photovoltaic-art/SUNDIAL/hardware/carrier/bom.csv

References | Qty | Value / rating | Footprint | Fitted | Manufacturer | MPN | Confirm | Placement | Section (first) | Notes
BT1 | 1 | CR2032 holder (no charging) | Battery:BatteryHolder_Keystone_3034_1x20mm | yes | Keystone Electronics | 3034 |  | BT1: near - U1 pin 14 (VBAT) | 5
C3 | 1 | 470u 10 V low ESR | Capacitor_SMD:CP_Elec_8x10.5 | yes | Panasonic | EEE-FK1A471P | 470 uF 10 V FK series, 8 x 10.2 mm; check fit on the 8 x 10.5 footprint | C3: critical - J14 pin 15 (ESP32 VIN) to J14 pin 14 (GND) | 3 | Close to ESP32 VIN
C4 C5 C6 C9 C10 | 5 | 100n | Capacitor_SMD:C_0603_1608Metric | yes | Murata | GRM188R71H104KA93D |  | C4: critical - J14 pin 15 (VIN), next to C3; C5: critical - J14 pin 4 (GPIO 34) to GND, with R2; C6: critical - U2 pin 5 (VS) to U2 pin 2 (GND); C9: critical - J8 pin 4 (VDD), next to C8; C10: critical - U1 pin 2 (VCC) to GND | 1 | U1 decoupling; U2 decoupling
C7 | 1 | 10n | Capacitor_SMD:C_0603_1608Metric | yes | Murata | GRM188R71H103KA01D |  | C7: critical - J14 pin 5 (GPIO 35) to GND, with R6 | 1
C8 | 1 | 10u | Capacitor_SMD:C_0805_2012Metric | yes | Murata | GRM21BR61C106KE15L |  | C8: critical - J8 pin 4 (VDD) to GND | 7
C11 C12 C13 | 3 | 1u | Capacitor_SMD:C_0603_1608Metric | yes | Murata | GRM188R71E105KA12D |  | C11: critical - U3 pin 2 (VDD) to U3 pin 4 (GND); C12: critical - U4 pin 5 (IN) to GND; C13: critical - U4 pin 1 (OUT) to GND | 1 | ADDED, not in spec v1: U3 supply decoupling (datasheet requirement); ADDED, not in spec v1: U4 input capacitor; ADDED, not in spec v1: U4 output capacitor
D0 | 1 | >=100 V >=15 A dual Schottky (e.g. 20 A 100 V) | Package_TO_SOT_SMD:TO-263-2 | yes | onsemi | MBRB20100CTT4G | D2PAK, 100 V 20 A dual common cathode, anodes (pins 1, 3) in parallel | D0: critical - Right after J1, in the sun loop J1 -> D0 -> Q1 -> RSH1 | 1 | Input protection; cooling area; carries AUX current too
D1 | 1 | S3M (1000 V 3 A) | Diode_SMD:D_SMC | yes | Vishay | S3M-E3/57T |  | D1: near - Between F1 and J2 (buck input) | 2 | Reverse polarity; blocks Q1 pulses
D2 | 1 | SMAJ5.0A (TVS, unidirectional) | Diode_SMD:D_SMA | yes | Littelfuse | SMAJ5.0A |  | D2: near - J3 (buck output terminal) | 3
D3 | 1 | ESD 3.3 V (e.g. PESD3V3L1BA) | Diode_SMD:D_SOD-323 | yes | Nexperia | PESD3V3L1BA,115 |  | D3: critical - J4 pin 2 (DQ_T), short path to GND | 6 | At the terminal
D4 | 1 | SS14 (flyback clamp) | Diode_SMD:D_SMA | yes | Vishay | SS14-E3/61T |  | D4: near - J11 pin 2 (5V SW) | 9
D5 | 1 | Schottky >=100 V >=10 A (MBR10100 class) | Package_TO_SOT_THT:TO-220-2_Vertical | yes | onsemi | MBR10100G |  | D5: near - Next to J12, with copper for cooling | 10 | Essential: isolates add-on capacitors from Q1 pulses; heatsink if AUX > ~2 A
D6 | 1 | DNP: SMCJ58A TVS (fit after bench test if needed) | Diode_SMD:D_SMC | no (DNP) | Littelfuse | SMCJ58A | DNP | D6: near - Q1 drain (PV+), short path to the star ground | 1 | ADDED, review 2: footprint only. If fitted, Q1 must be >= 100 V (clamp ~90 V)
F1 | 1 | 2 A slow-blow | Fuse:Fuse_1812_4532Metric | yes | (manufacturer to propose) |  | 1812 time-delay (slow-blow) fuse, 2 A, >= 63 V DC. If no 1812 part suits, Bourns SF-1206S200-2 (1206, 2 A time-lag) with the footprint changed to 1206 | F1: near - Off the Q1 drain node (PV+), start of the board-supply branch | 2 | After the Q1 node
F2 | 1 | PTC 0.5 A hold | Fuse:Fuse_1206_3216Metric | yes | Bourns | MF-NSMF050-2 |  | F2: free - Between the +5V rail and J11 pin 1 | 9
F3 | 1 | PTC 0.2 A hold | Fuse:Fuse_0805_2012Metric | yes | Bourns | MF-PSMF020X-2 | 0805, 0.2 A hold; confirm size | F3: free - Between +3V3 and the header/J11 3V3 pins | 9 | Feeds J11 3V3 and the header 3V3 pins
F4 | 1 | ATO blade holder, fuse NOT fitted (<=3 A on v1; 9 A only with D5 heatsink) | Fuse:FuseHolder_Blade_ATO_Littelfuse_FLR_178.6165 | holder only | Littelfuse | 178.6165.0002 | Holder only, fuse not fitted | F4: near - High-current path D0 -> F4 -> D5 -> J12 | 10 | Empty holder = AUX dead
H1 H2 H3 H4 | 4 | M3 | MountingHole:MountingHole_3.2mm_M3 | yes |  |  | mounting holes, no part |  | Mechanical | 3.5 mm from corners, provisional
J1 | 1 | PANEL+ / PANEL- (>=15 A, 4-6 mm2) | TerminalBlock_MetzConnect:TerminalBlock_MetzConnect_Type067_RT01902HDWC_1x02_P10.00mm_Horizontal | yes | Metz Connect | RT01902HDWC |  |  | 1 | Board edge; GND here is PANEL-
J2 | 1 | BUCK IN + / - | TerminalBlock_Phoenix:TerminalBlock_Phoenix_MKDS-1,5-2-5.08_1x02_P5.08mm_Horizontal | yes | Phoenix Contact | 1715721 | MKDS 1,5/ 2-5,08 |  | 2 | To ANGEEK buck input
J3 | 1 | BUCK OUT + / - (set 5.0 V) | TerminalBlock_Phoenix:TerminalBlock_Phoenix_MKDS-1,5-2-5.08_1x02_P5.08mm_Horizontal | yes | Phoenix Contact | 1715721 | MKDS 1,5/ 2-5,08 |  | 3
J4 | 1 | DS18B20: 3V3 / DATA / GND | TerminalBlock_Phoenix:TerminalBlock_Phoenix_PT-1,5-3-3.5-H_1x03_P3.50mm_Horizontal | yes | Phoenix Contact | 1984633 | PT 1,5/ 3-3,5-H |  | 6 | red / yellow / black
J5 | 1 | Optional 2nd probe | TerminalBlock_Phoenix:TerminalBlock_Phoenix_PT-1,5-3-3.5-H_1x03_P3.50mm_Horizontal | yes | Phoenix Contact | 1984633 | PT 1,5/ 3-3,5-H |  | 6 | In parallel with J4
J6 | 1 | Supercap 2.7 V 10 F (upper) | TerminalBlock_Phoenix:TerminalBlock_Phoenix_MKDS-1,5-2-5.08_1x02_P5.08mm_Horizontal | yes | Phoenix Contact | 1715721 | MKDS 1,5/ 2-5,08 |  | 3 | Silkscreen - side (stripe)
J7 | 1 | Supercap 2.7 V 10 F (lower) | TerminalBlock_Phoenix:TerminalBlock_Phoenix_MKDS-1,5-2-5.08_1x02_P5.08mm_Horizontal | yes | Phoenix Contact | 1715721 | MKDS 1,5/ 2-5,08 |  | 3 | Silkscreen - side (stripe)
J8 | 1 | microSD push-push with detect (Hirose DM3AT) | Connector_Card:microSD_HC_Hirose_DM3AT-SF-PEJM5 | yes | Hirose | DM3AT-SF-PEJM5 |  |  | 7 | At a board edge; DAT1, DAT2 not used in SPI mode
J9 | 1 | Spare: 3V3 GND 32 33 36 26 27 13 14 | Connector_PinHeader_2.54mm:PinHeader_1x09_P2.54mm_Vertical | yes | Würth Elektronik | 61300911121 |  |  | 8 | Silkscreen: 32/33/36 analog, 36 input only
J10 | 1 | UART: 3V3 GND RX2(16) TX2(17) | Connector_PinHeader_2.54mm:PinHeader_1x04_P2.54mm_Vertical | yes | Würth Elektronik | 61300411121 |  |  | 8
J11 | 1 | 5V / 5V SW / 3V3 / GND | TerminalBlock_Phoenix:TerminalBlock_Phoenix_PT-1,5-4-3.5-H_1x04_P3.50mm_Horizontal | yes | Phoenix Contact | 1984646 | PT 1,5/ 4-3,5-H |  | 9
J12 | 1 | AUX + / - (>=15 A) | TerminalBlock_MetzConnect:TerminalBlock_MetzConnect_Type067_RT01902HDWC_1x02_P10.00mm_Horizontal | yes | Metz Connect | RT01902HDWC |  |  | 10 | AUX- is PANEL-: never through the shunt
J13 | 1 | I2C: 3V3 GND SDA SCL | Connector_PinHeader_2.54mm:PinHeader_1x04_P2.54mm_Vertical | yes | Würth Elektronik | 61300411121 |  |  | 8
J14 | 1 | ESP32 left row: EN,36,39,34,35,32,33,25,26,27,14,12,13,GND,VIN | Connector_PinSocket_2.54mm:PinSocket_1x15_P2.54mm_Vertical | yes | Würth Elektronik | 61301511821 | Female socket, 15 way; confirm it is the socket, not the pin header |  | 4 | Row spacing 25.4 mm, provisional
J15 | 1 | ESP32 right row: 23,22,1,3,21,19,18,5,17,16,4,2,15,GND,3V3 | Connector_PinSocket_2.54mm:PinSocket_1x15_P2.54mm_Vertical | yes | Würth Elektronik | 61301511821 | Female socket, 15 way; confirm it is the socket, not the pin header |  | 4 | EN, 1, 3, 2, 12, 15 not brought out
JP1 | 1 | Jumper: remove = sun sensor off | Connector_PinHeader_2.54mm:PinHeader_1x02_P2.54mm_Vertical | yes | Würth Elektronik | 61300211121 | Plus a 2.54 mm jumper (fitted by the builder) |  | 1
LED1 | 1 | Green, ~0.3 mA | LED_SMD:LED_0603_1608Metric | yes | Würth Elektronik | 150060GS75000 |  | LED1: free - Visible when the box is open | 3 | 5 V present; dim on purpose
Q1 | 1 | N-MOSFET >=60 V (>=100 V if D6 fitted) >=20 A Rds(on)<=20 mOhm @4.5 V | Package_TO_SOT_SMD:TO-252-2 | yes | Infineon | IRLR3110ZTRPBF | 100 V logic-level D-Pak; confirm Rds(on) <= 20 mOhm at Vgs 4.5 V from the datasheet |  | 1 | Sun sensor: shorts the panel ~1 ms every 10 s
R1 | 1 | 100k 1% | Resistor_SMD:R_0805_2012Metric | yes | Yageo | RC0805FR-07100KL |  | R1: near - Next to R2; its top end on PV_F after F1 | 2
R2 | 1 | 4k7 1% | Resistor_SMD:R_0603_1608Metric | yes | Yageo | RC0603FR-074K7L |  | R2: near - J14 pin 4 (ESP32 GPIO 34), with C5 | 2 | Was 5k6; changed after review (48 V -> 2.15 V)
R4 | 1 | 10R | Resistor_SMD:R_0603_1608Metric | yes | Yageo | RC0603FR-0710RL |  | R4: critical - Q1 gate pad, between U3 pin 5 (OUT) and Q1 gate | 1
R5 R9 R14 R15 R16 R17 | 6 | 10k | Resistor_SMD:R_0603_1608Metric | yes | Yageo | RC0603FR-0710KL |  | R5: near - U3 pin 3 (IN); R9: free - Next to LED1; R14: near - J8 pin 2 (CS); R15: near - J8 pin 3 (MOSI); R16: near - J8 pin 7 (MISO); R17: near - J8 pin 10 (detect) | 1 | Also keeps GPIO 5 high at boot; Q1 stays off while the ESP32 boots
R6 | 1 | 1k | Resistor_SMD:R_0603_1608Metric | yes | Yageo | RC0603FR-071KL |  | R6: near - J14 pin 5 (ESP32 GPIO 35), together with C7 | 1
R7 R8 | 2 | 10k | Resistor_SMD:R_0805_2012Metric | yes | Yageo | RC0805FR-0710KL |  | R7: near - J6 (upper supercap terminal), across +5V and MID; R8: near - J7 (lower supercap terminal), across MID and GND | 3 | Balancing
R10 R11 R12 | 3 | 4k7 | Resistor_SMD:R_0603_1608Metric | yes | Yageo | RC0603FR-074K7L |  | R10: free - On SDA, near U1 or J13; R11: free - On SCL, near U1 or J13; R12: near - J4/J5 | 5
R13 | 1 | 100R | Resistor_SMD:R_0603_1608Metric | yes | Yageo | RC0603FR-07100RL |  | R13: near - Between J4/D3 and the ESP32 side of DQ | 6
R18 R21 | 2 | 100k | Resistor_SMD:R_0603_1608Metric | yes | Yageo | RC0603FR-07100KL |  | R18: near - U4 pin 4 (EN); R21: critical - Directly across Q1 gate and source pads | 1 | ADDED, review 2: Q1 gate-source pull-down; holds Q1 off while U3 is unpowered at dawn; Switched output off at boot
R19 | 1 | 0R | Resistor_SMD:R_0603_1608Metric | yes | Yageo | RC0603JR-070RL |  | R19: near - U4 pin 4 (EN), on the trace from GPIO 27 | 9 | Remove to free GPIO 27
R20 | 1 | DNP | Resistor_SMD:R_0603_1608Metric | no (DNP) | Yageo | RC0603FR-071KL | DNP; value to set on the bench if a long probe cable needs it | R20: near - J4/J5, beside R12 | 6 | Spec ref R12b. Footprint only: stronger pull-up for long cable
RSH1 | 1 | 5m 1% 2512 >=2 W | Resistor_SMD:R_2512_6332Metric | yes | Bourns | CRA2512-FZ-R005ELF | 5 mOhm 1 % 3 W |  | 1 | Spec ref R_SH. Kelvin connections to U2; star ground at the GND end
RSH2 | 1 | DNP (option: 2x 10m) | Resistor_SMD:R_2512_6332Metric | no (DNP) | Bourns | CRA2512-FZ-R010ELF | DNP; option: two in parallel instead of RSH1 |  | 1 | Spec ref R_SH2. Footprint only
TP1 | 1 | PV+ | TestPoint:TestPoint_Loop_D2.50mm_Drill1.0mm | yes | Keystone Electronics | 5000 |  |  | 8
TP2 | 1 | BUCK_IN+ | TestPoint:TestPoint_Loop_D2.50mm_Drill1.0mm | yes | Keystone Electronics | 5000 |  |  | 8
TP3 | 1 | +5V | TestPoint:TestPoint_Loop_D2.50mm_Drill1.0mm | yes | Keystone Electronics | 5000 |  |  | 8
TP4 | 1 | MID | TestPoint:TestPoint_Loop_D2.50mm_Drill1.0mm | yes | Keystone Electronics | 5000 |  |  | 8
TP5 | 1 | +3V3 | TestPoint:TestPoint_Loop_D2.50mm_Drill1.0mm | yes | Keystone Electronics | 5000 |  |  | 8
TP6 | 1 | GND | TestPoint:TestPoint_Loop_D2.50mm_Drill1.0mm | yes | Keystone Electronics | 5000 |  |  | 8
TP7 | 1 | VDIV | TestPoint:TestPoint_Loop_D2.50mm_Drill1.0mm | yes | Keystone Electronics | 5000 |  |  | 8
TP8 | 1 | ISENSE | TestPoint:TestPoint_Loop_D2.50mm_Drill1.0mm | yes | Keystone Electronics | 5000 |  |  | 8
TP9 | 1 | GATE | TestPoint:TestPoint_Loop_D2.50mm_Drill1.0mm | yes | Keystone Electronics | 5000 |  |  | 8
TP10 | 1 | RTC_INT | TestPoint:TestPoint_Loop_D2.50mm_Drill1.0mm | yes | Keystone Electronics | 5000 |  |  | 8
TP11 | 1 | RTC_32K | TestPoint:TestPoint_Loop_D2.50mm_Drill1.0mm | yes | Keystone Electronics | 5000 |  |  | 8
U1 | 1 | DS3231SN (or RV-3028-C7, firmware change) | Package_SO:SOIC-16W_7.5x10.3mm_P1.27mm | yes | Analog Devices / Maxim | DS3231SN# |  |  | 5 | Symbol DS3231M has the same pinout as DS3231SN (pins 5-12 to GND); RST not connected
U2 | 1 | INA180A3 (gain 100) | Package_TO_SOT_SMD:SOT-23-5 | yes | Texas Instruments | INA180A3IDBVR |  |  | 1 | IN+ and IN- by Kelvin traces from the inner ends of RSH1's pads
U3 | 1 | MCP1416 (or TC4427A class) | Package_TO_SOT_SMD:SOT-23-5 | yes | Microchip | MCP1416T-E/OT |  |  | 1 | Non-inverting, 5 V gate drive
U4 | 1 | Load switch 5 V >=1 A, active-high EN, soft start (AP22804AW5 / TPS22918 class) | Package_TO_SOT_SMD:SOT-23-5 | yes | Diodes Inc. | AP22804AW5-7 |  |  | 9 | Fed from +5V as in the spec; FLG not used
Fitted by the builder (not assembled): |  | ELEGOO ESP32 30-pin; ANGEEK buck 8-60 V set to 5.0 V; 2x 2.7 V 10 F supercaps; CR2032; DS18B20 probe(s); JP1 jumper; AUX fuse; microSD card |  |  |  |  |  |  |  | See CARRIER.md
