photovoltaic-art/SUNDIAL/budget/SUNDIAL-budget.xlsx

Sheet: Summary
SUNDIAL: budget to build the nine panels
Draft, 25 Oct 2026. Hardware, the first event, and yearly running costs (Sole and the event).
Node | Cost (€) | Share
Panels and boards
Sundial hardware
Mounting and plates
The event (2027)
Website, permissions, insurance
Shared and spares
Build subtotal
Contingency
Build total
Each following year: insurance, domain, upkeep, the year's print
Total to build and run the first year
Contingency rate | 15%
Option, not in the total:
Post panel (in place of one wall)
How to use it
Edit only the blue cells: quantities, unit prices and Include (Yes/No) on the Lines sheet, and the contingency rate above (yellow).
Basis on each line: Quote (from the supplier), Listed price (seen online, Oct 2026), Estimate (to be confirmed).
Prices include VAT. The first year's insurance, domain and print are in the build cost; the yearly figure starts from the second year.
To include a post panel, set its lines' Include to Yes on the Lines sheet.
Not included: PVA's labour and travel; the print's sale income.

Sheet: Lines
Node | Item | Qty | Unit (€) | Total (€) | Basis | Source / note | Include
Panels and boards | Retired PV panel, Trina TSM-185DC01 class (9 + 1 spare) | 10 | €30 |  | Estimate | Second-hand / end-of-life; may be donated. Source still to confirm | Yes
Panels and boards | Board designer: schematic review, layout, files (CARRIER.md brief) | 1 | €1000 |  | Estimate | One-off; get quotes (Italian/European design house) | Yes
Panels and boards | Carrier v1, small run of 5, assembled (bench test of the sun sensor) | 5 | €100 |  | Estimate | Small-run setup costs make v1 dear per board | Yes
Panels and boards | Carrier v2, run of 10, assembled (9 panels + 1 spare) | 10 | €60 |  | Estimate | CARRIER.md: order 5 of v1, fix, then 10 of v2 | Yes
Panels and boards | ELEGOO ESP32 30-pin dev boards (v1 bench + v2) | 15 | €9 |  | Estimate |  | Yes
Panels and boards | Buck converter modules (8–60 V in, 5 V out) | 15 | €5 |  | Estimate |  | Yes
Panels and boards | Supercapacitor pairs (2 x 10 F), DS18B20 probe, CR2032 | 10 | €12 |  | Estimate |  | Yes
Panels and boards | IP65 box, glands, breather vent, tamper screws | 10 | €32 |  | Estimate | CARRIER.md: about 150 x 110 x 70 mm | Yes
Panels and boards | Cable, fuses, terminals | 10 | €15 |  | Estimate |  | Yes
Sundial hardware | Gnomon: 15 mm aluminium tube, 45 cm, TIG-welded to its mount | 9 | €40 |  | Estimate | Local fabrication; GNOMON.md | Yes
Sundial hardware | Hour lines and date marks: UV-stable vinyl pinstripe tape, per panel | 9 | €10 |  | Estimate | No numbers, no brackets; GNOMON.md | Yes
Sundial hardware | Stand-offs (aluminium angle) and M6 stainless fixings | 9 | €30 |  | Estimate |  | Yes
Sundial hardware | Hour-line tape test (pilot panel) | 1 | €20 |  | Estimate | README to-do | Yes
Mounting and plates | Wall fixings (anchors, brackets) | 9 | €25 |  | Estimate |  | Yes
Mounting and plates | Wall plate: number and QR code | 9 | €20 |  | Estimate |  | Yes
The event (2027) | Girasole: dwarf sunflowers, pots, soil | 1 | €40 |  | Estimate |  | Yes
The event (2027) | Girasole: chalkboard, stand, ochre and blue chalk | 1 | €90 |  | Estimate |  | Yes
The event (2027) | Flyers | 1 | €100 |  | Estimate |  | Yes
The event (2027) | Screen print set-up: four screens and films | 1 | €400 |  | Estimate | Awaiting the print shop's answer (texts/print-enquiry.md) | Yes
The event (2027) | Screen print run | 50 | €10 |  | Estimate | Edition size and price per print still open; sales may cover it | Yes
Website, permissions, insurance | Domain photovoltaic.art, first year | 1 | €30 |  | Estimate | Check the renewal price (PVA TASKS.md) | Yes
Website, permissions, insurance | Public liability insurance, first year | 1 | €400 |  | Estimate | Get a quote | Yes
Website, permissions, insurance | Permission costs (applications, stamps) | 1 | €100 |  | Estimate | Depends on the route: patto di collaborazione or authorisation | Yes
Shared and spares | Spares: supercaps, coin cells, probe, fixings | 1 | €60 |  | Estimate | SUNDIAL.md 5 | Yes
Shared and spares | Bench supply and test leads | 1 | €60 |  | Estimate | If not already owned | Yes
Shared and spares | Shipping | 1 | €100 |  | Estimate |  | Yes
Post option | Steel post and base | 1 | €450 |  | Estimate | Only where no wall works (POST.md) | No
Post option | Structural engineer's sign-off | 1 | €400 |  | Estimate |  | No
Post option | USB-C PD charger module, sockets, shelf, plate | 1 | €110 |  | Estimate |  | No
Running, each year | Insurance renewal | 1 | €400 |  | Estimate |  | Yes
Running, each year | Domain renewal | 1 | €30 |  | Estimate |  | Yes
Running, each year | Upkeep: coin cells, supercaps over time, cleaning | 1 | €60 |  | Estimate |  | Yes
Running, each year | Screen print set-up for the year's print | 1 | €400 |  | Estimate | Each event makes a new print | Yes
