photovoltaic-art/SUNDIAL/hardware/carrier/outline.dxf

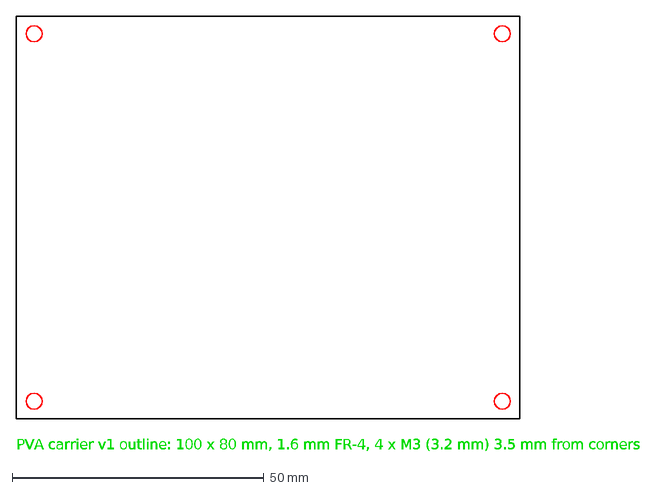
[picture p4: CAD file, 2026-10-27]
hardware/carrier/outline.dxf
PVA carrier v1 outline: 100 x 80 mm, 1.6 mm FR-4, 4 x M3 (3.2 mm) 3.5 mm from corners
