photovoltaic-art/SUNDIAL/hardware/carrier/carrier_schematic.pdf

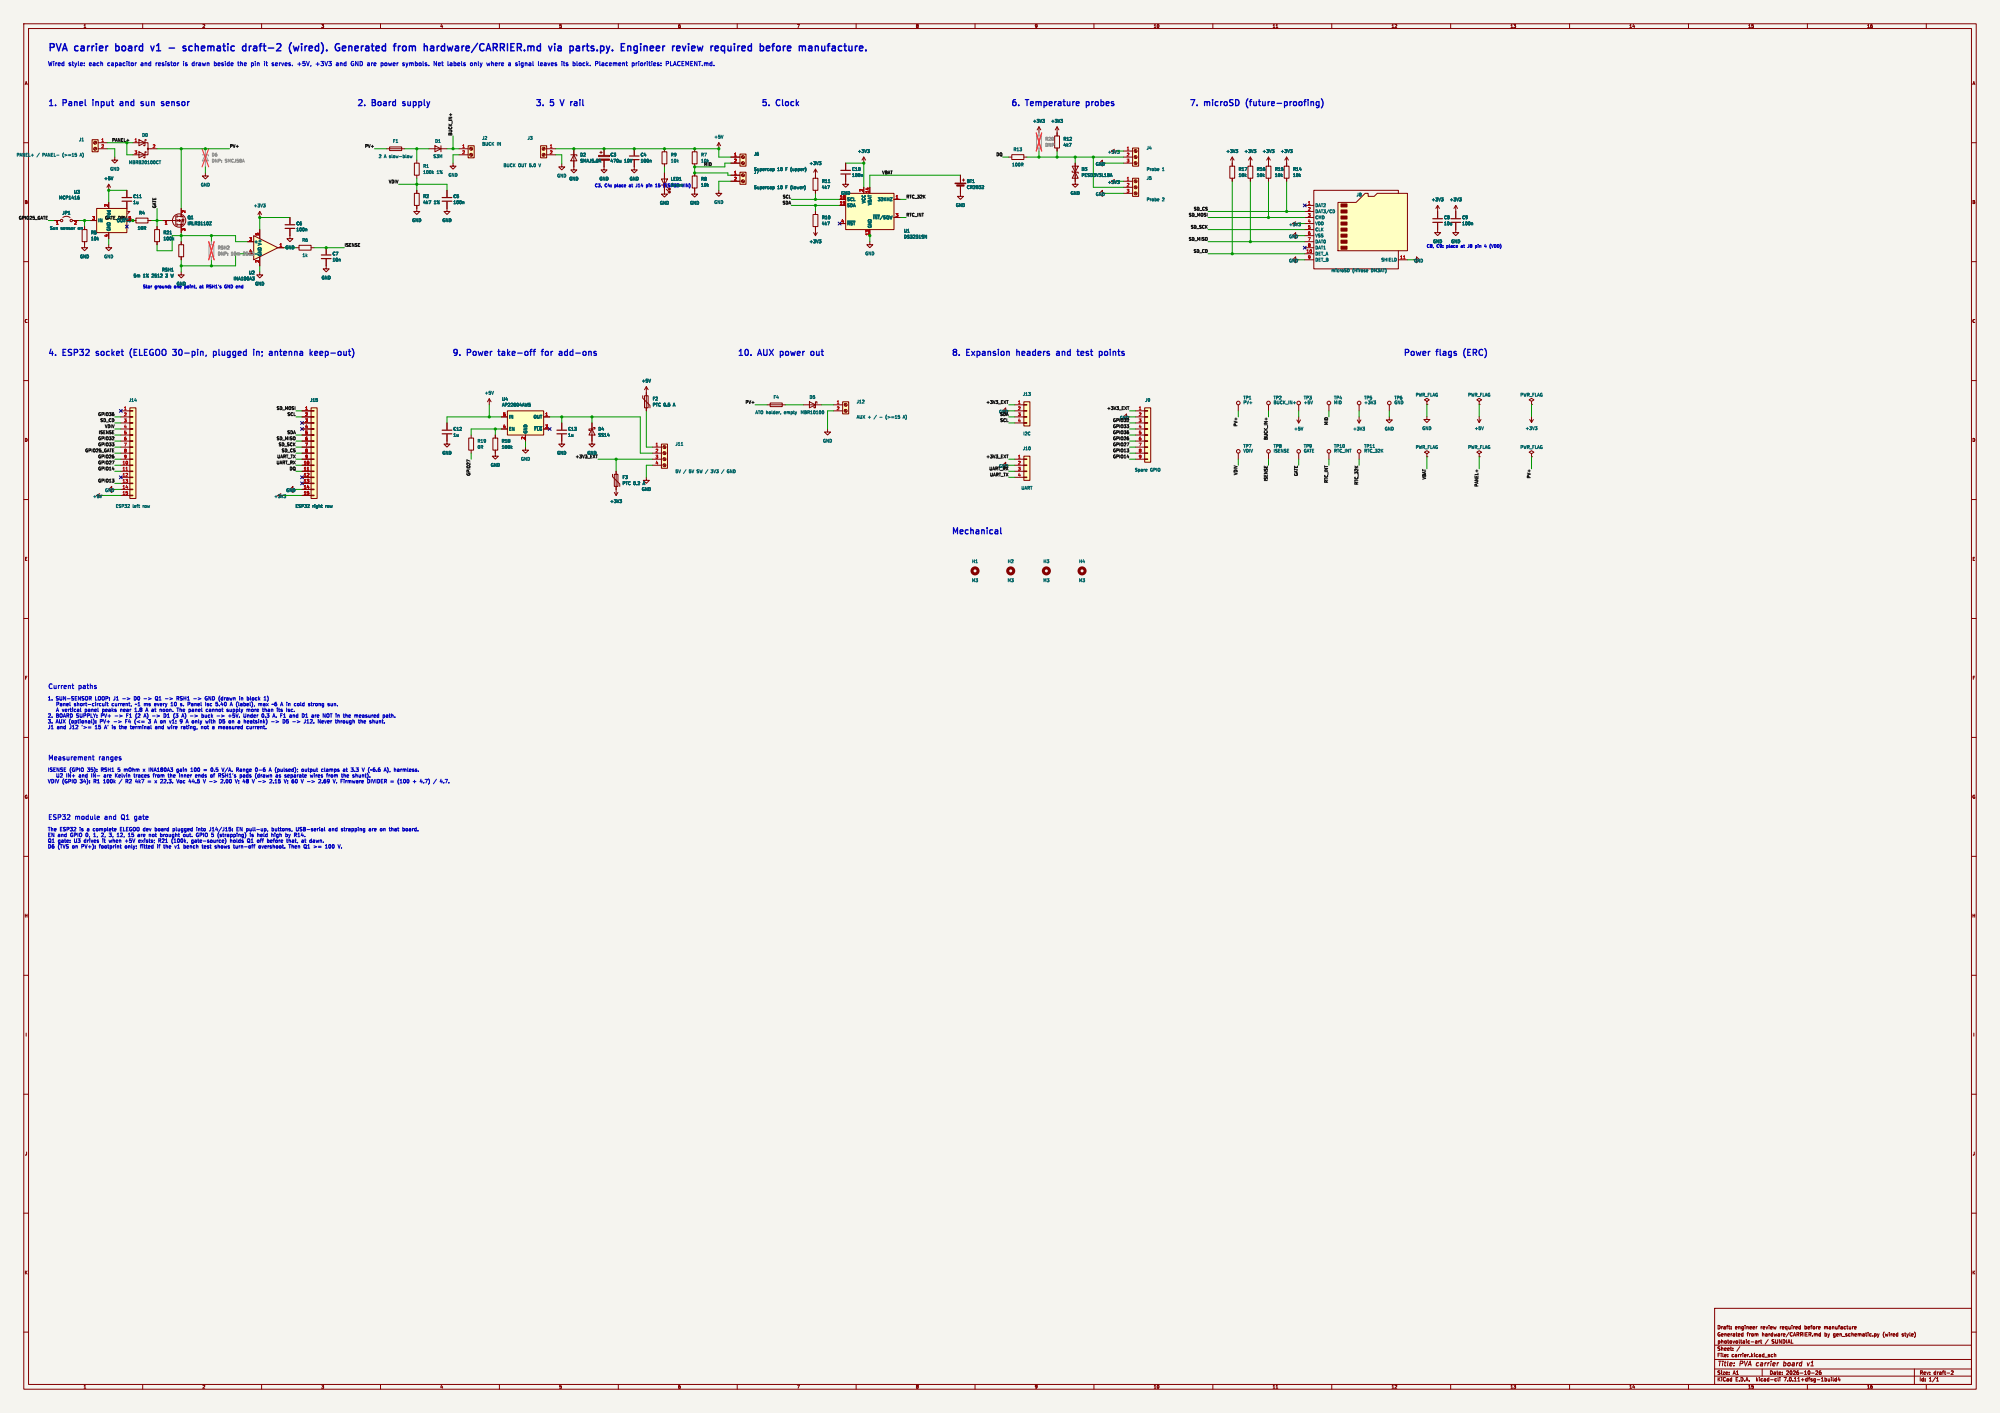
[picture p5: page 1]

8. Expansion headers and test points

Id: 1/1 Title: PVA carrier board v1
