photovoltaic-art/SUNDIAL/(commit log)

2026-10-25 Review fixes and a first budget
    README: the panel is the Trina TSM-185DC01 (was '180 W'). SUNDIAL.md:
    the post variant in layer 1, permissions and upkeep. CARRIER.md: wall or
    post. budget/SUNDIAL-budget.xlsx: about EUR 6,400 to build, EUR 7,300
    with contingency, EUR 890 each following year.
    Claude-Session: https://claude.ai/code/session_01PYggKV6J6nFvCyx7PSvpos
    [SUNDIAL-budget.xlsx]
2026-10-26 Carrier: placement guide for every passive (PLACEMENT.md, BOM Placement column), answering Rush PCB
    Claude-Session: https://claude.ai/code/session_01BMFMt5yCJVT3JQicJnUWqs
    [bom.csv]
2026-10-26 Carrier schematic draft-2: wired style (passives beside and wired to their pins, power symbols, labels only between blocks); netlist unchanged, verified net by net
    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
    [carrier.kicad_sch]
2026-10-26 Carrier schematic: placement note for C3/C4 at ESP32 VIN
    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
    [carrier.kicad_sch]
2026-10-27 Growth model: year 1 SUNDIAL by PVA, year 2 the same nine panels become SUNSET, each node owned separately
    PVA/GROWTH.md: SUNDIAL (no tokens, PVA owns and manages) grows into
    SUNSET at the year-2 spring visit: 4 walls by firmware, 5 interactive
    nodes on the battery tier; anyone can own a node and hold its key; PVA
    writes firmware and rules and manages the website. Sundials stay; Sole
    continues with reference sun sensors. Year-1 sites chosen for year-2
    roles. Linked from SUNDIAL and SUNSET; tokenomics governance adopted.
    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
2026-10-27 As simple as possible: one board everywhere, one firmware image per work, identity written at installation
    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
2026-10-27 Carrier: board outline fixed (100 x 80 mm, M3 holes 3.5 mm from corners) with outline.dxf; mounting on the box's plate
    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
    [outline.dxf]
2026-10-28 Carrier spec: planned for v2, dual-gain sun sensor (U2B INA180A1 on GPIO 36)
    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
2026-10-28 Carrier layout rule 9: J9, J10, J13 side by side on one edge (for the SUNSET I/O board cables); pending note for Rush PCB
    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
2026-10-28 Website: About (intro), Bosa 2027, map moved to map.html, Sole preview
    - index.html is now the introduction: date-aware line, wall-plate panel card (?p=N), year-1 diagram, how to read a dial
    - bosa.html: the event, a visit, the print, privacy; 63-dial preview sheet on invented data
    - sole.html: sample editions on invented data, drawn by the panel's rules-1 code
    - map.html: the map, moved from index.html, with a back link and a first-visit tip
    - assets/dial.js holds the drawing rules (copied from the panel page) and the EVENT dates
    - map.txt points panels back to /map.html; README documents the links and QR codes
    Claude-Session: https:/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
2026-10-28 Website: newcomer review - clearer names (SUNDIAL, Bosa, La Meridiana), simpler diagram, no jargon in figures, prints 'details to follow'
    Claude-Session: https://claude.ai/code/session_01C94yzC7Tpd7mvYULYVqV5X
2026-10-29 Task: wall plate design with the node logo in the centre of the QR code
    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
2026-10-29 Sundial face simplified: hour lines on the glass with no numbers, three date marks on the noon line (solstices, equinoxes), gnomon 45 cm
    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
    [SUNDIAL-budget.xlsx]
2026-10-30 Exploded diagram of a SUNDIAL panel: face, gnomon, wall plate, date marks, wedge, enclosure
    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
2026-10-30 Website: remove the date line at the top of About (the wall-plate panel card stays)
    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
2026-10-30 Website: 'How to read the monitor', with a paragraph on the digital layer the panel powers
    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
2026-10-30 Website: label 'The Monitor'; 'circuit board'
    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
2026-10-30 Carrier README: Rush PCB acknowledged placement and board details
    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
2026-10-31 MVP build: modules on a screw-terminal breakout, reference-cell sun sensor; carrier board on hold
    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
2026-10-31 MVP: wiring diagram (SVG + PNG); MVP is the core build for both years; battery-tier section
    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
